American-Embedded/isolated_reindvstrialize_usb_hub/mfg/main/schematic.pdf

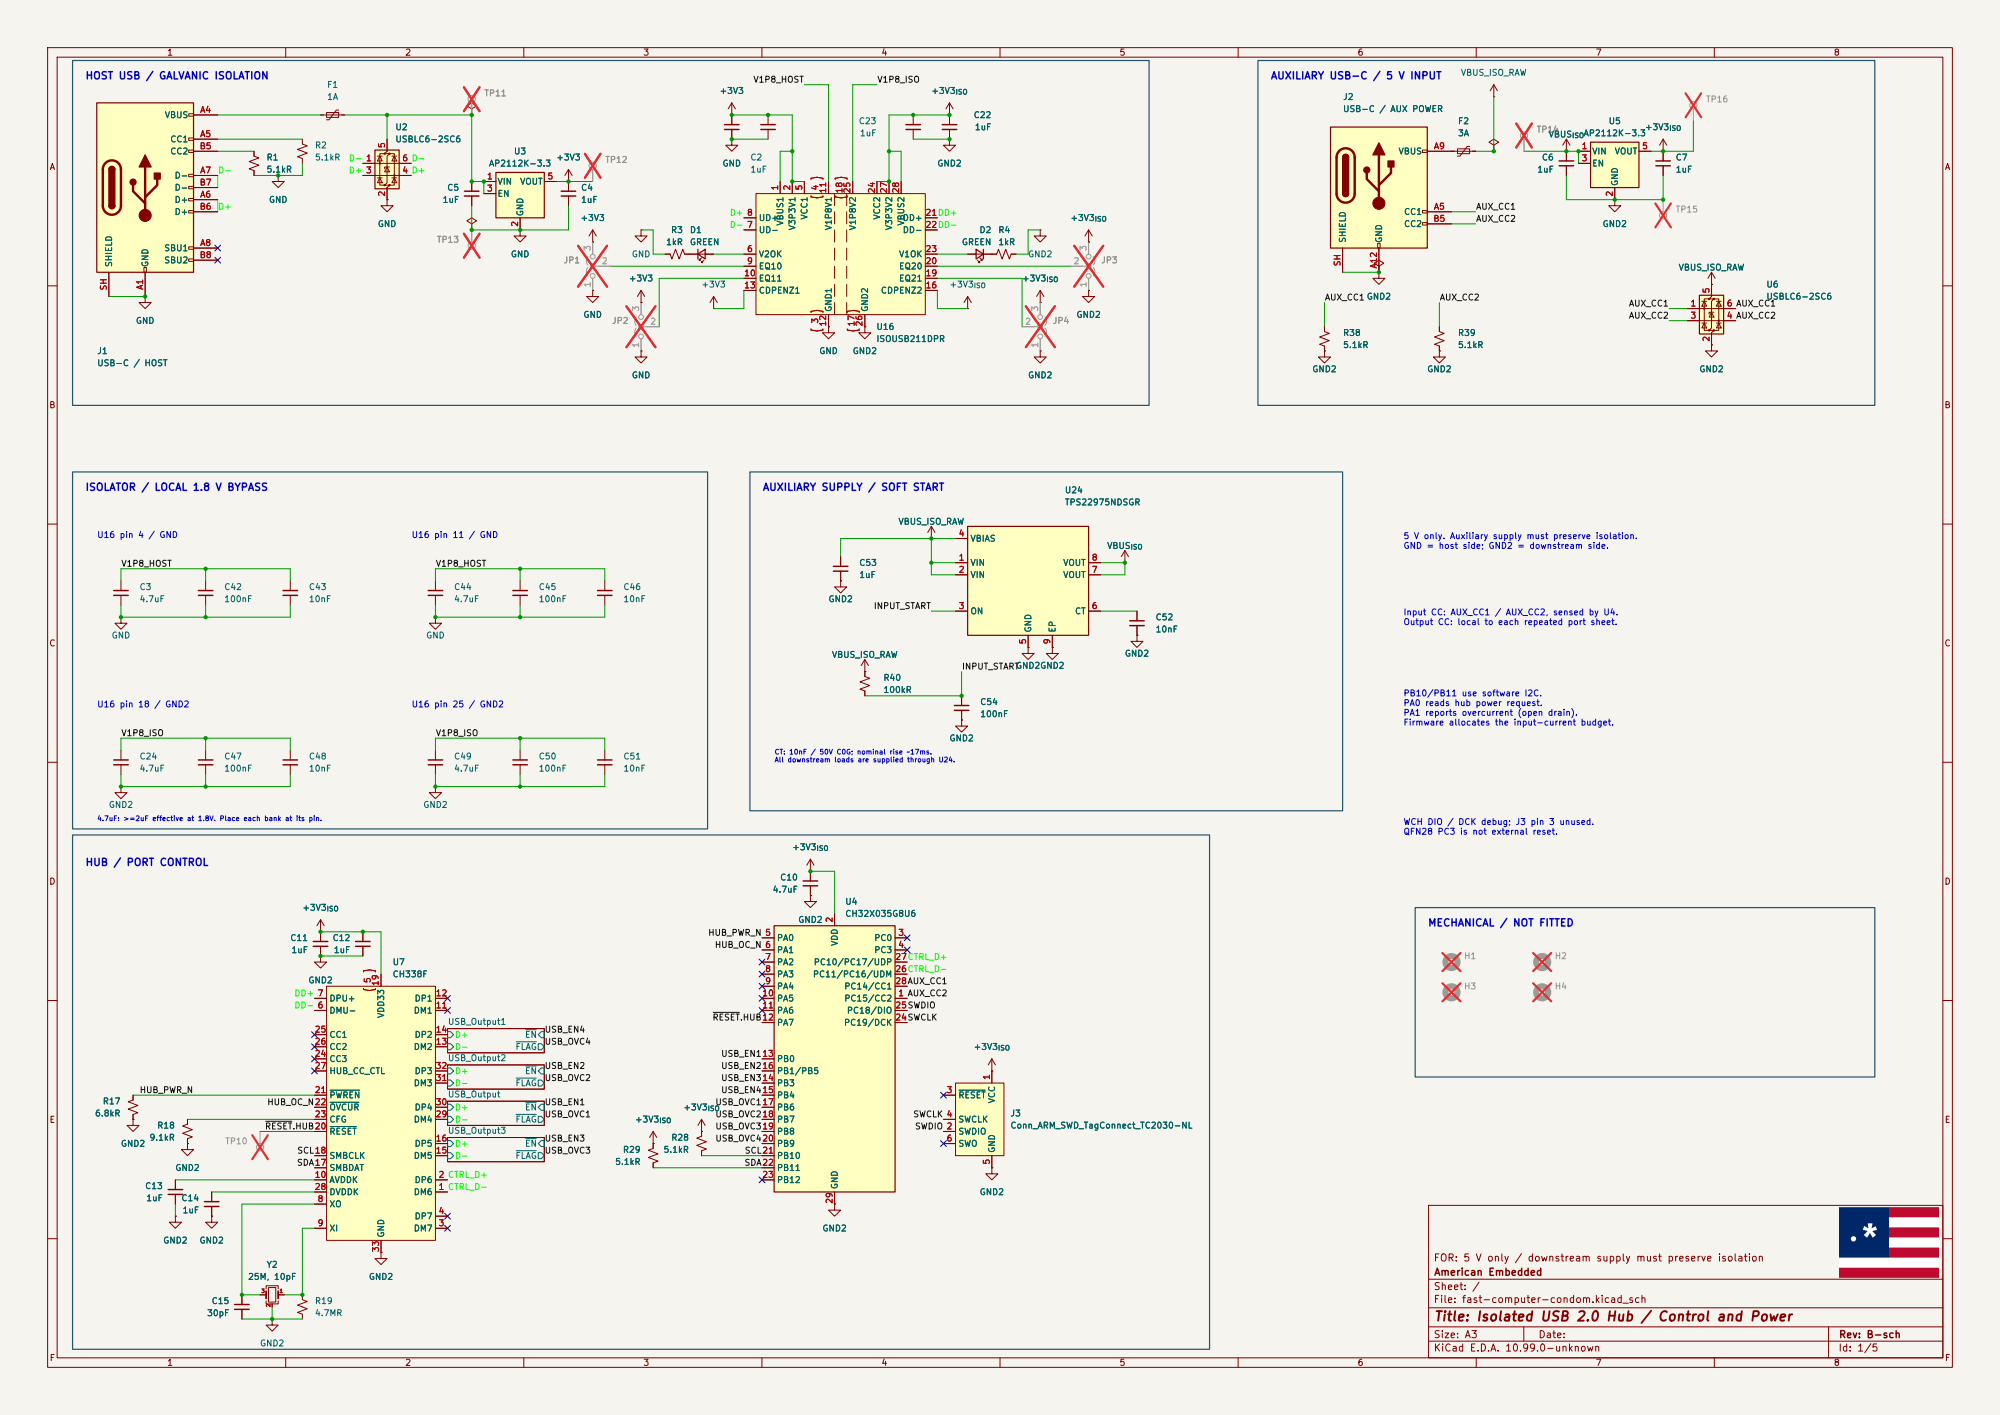
[picture p1: page 1]

HOST USB / GALVANIC ISOLATION

5 V only. Auxiliary supply must preserve isolation. GND = host side; GND2 = downstream side.

Input CC: AUX_CC1 / AUX_CC2, sensed by U4. Output CC: local to each repeated port sheet. PB10/PB11 use software I2C. PA0 reads hub power request. PA1 reports overcurrent (open drain). Firmware allocates the input-current budget.

2 PC0 3 PC3 4 PA0 5 PA1 6 PA2 7 PA3 8 PA4 9 PA5 10 PA6 11 PA7 12 PB0 13 PB3 14 PB4 15 PB6 17 PB7 18 PB8 19 PB9 20 PB10 21 PB11 22 PB12 23 PC19/DCK 24 PC18/DIO 25 PC11/PC16/UDM 26 PC10/PC17/UDP 27 PC14/CC1 28 GND 29

FOR: 5 V only / downstream supply must preserve isolation
American Embedded
Sheet: /
File: fast-computer-condom.kicad_sch
Title: Isolated USB 2.0 Hub / Control and Power

Size: A3 | Rev: B-sch | F Date:
KiCad E.D.A. 10.99.0-unknown | Id: 1/5

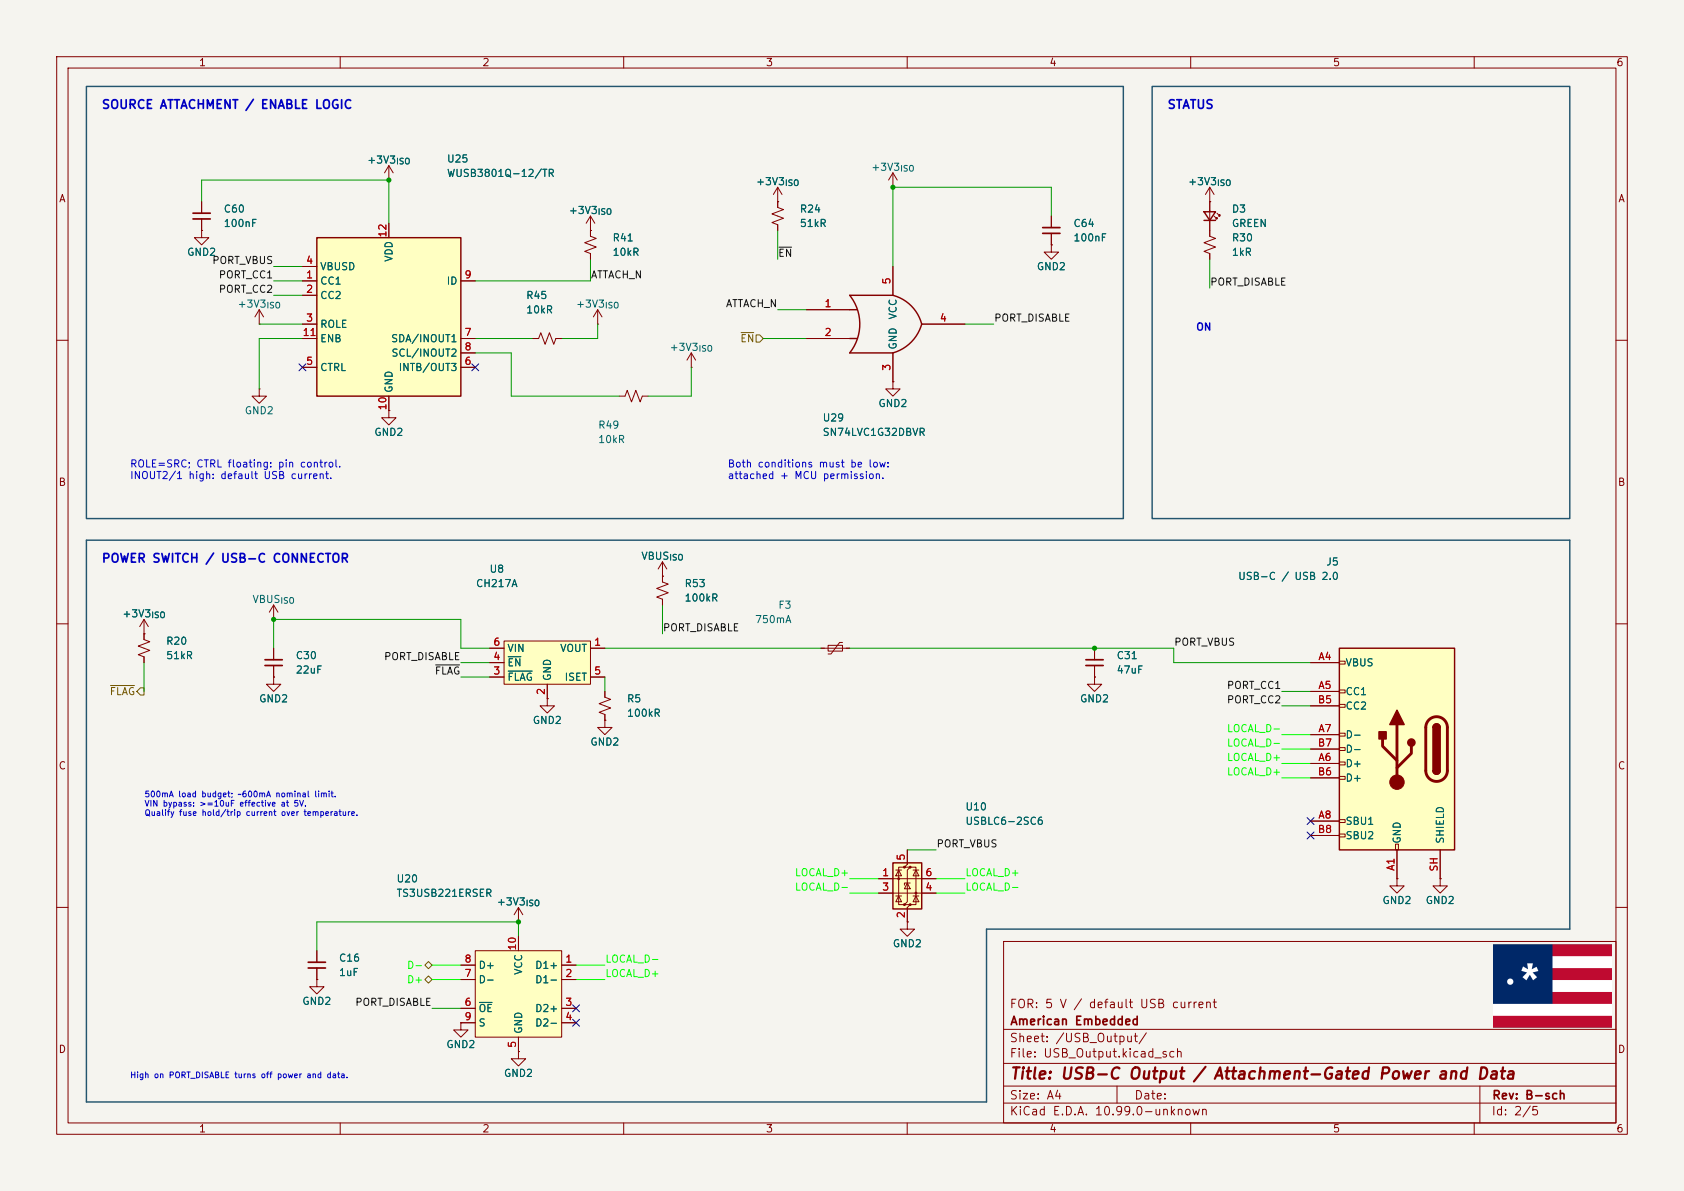
[picture p2: page 2]

SOURCE ATTACHMENT / ENABLE LOGIC

ROLE=SRC; CTRL floating: pin control.

500mA load budget; ~600mA nominal limit. VIN bypass: >=10uF effective at 5V. Qualify fuse hold/trip current over temperature. POWER SWITCH / USB-C CONNECTOR

FOR: 5 V / default USB current
American Embedded
Sheet: /USB_Output/
File: USB_Output.kicad_sch
Title: USB-C Output / Attachment-Gated Power and Data

High on PORT_DISABLE turns off power and data.

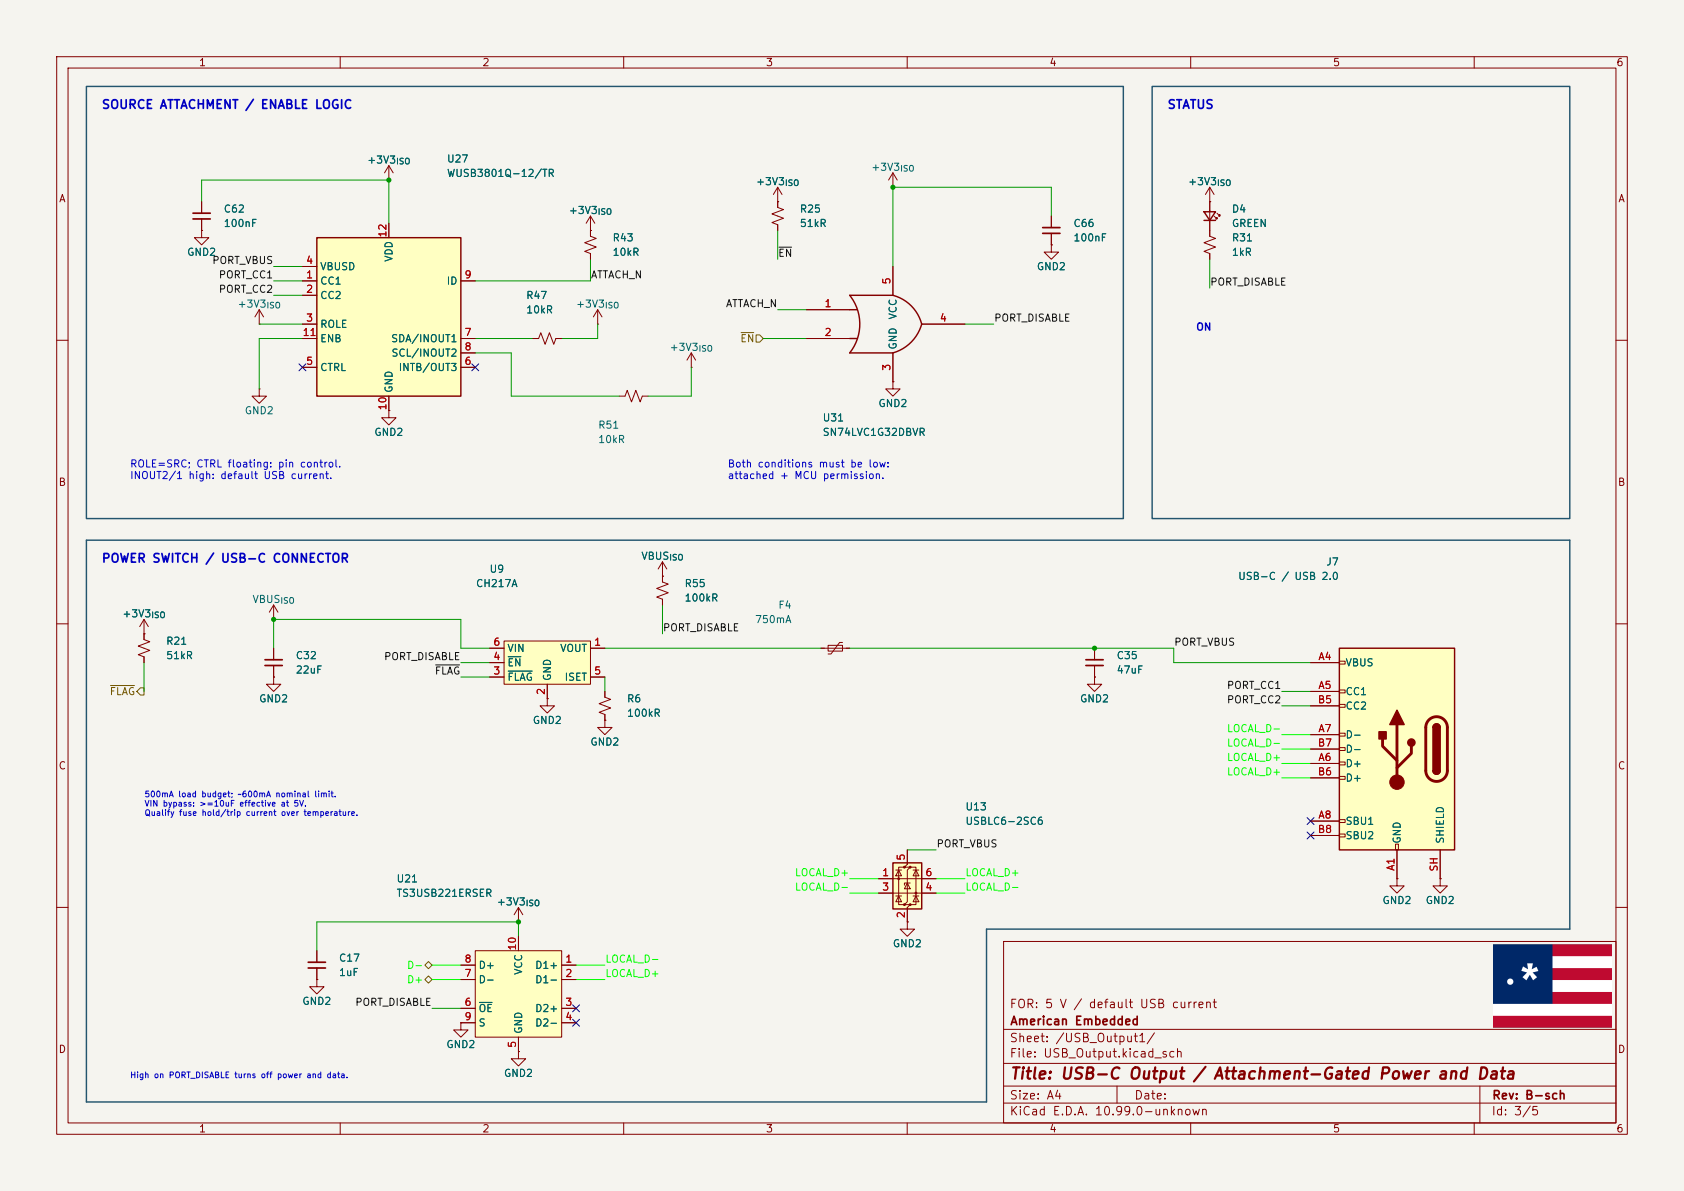
[picture p3: page 3]

SOURCE ATTACHMENT / ENABLE LOGIC
GND2 +3V3ISO GND2 C62

ROLE=SRC; CTRL floating: pin control.

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

FOR: 5 V / default USB current
American Embedded
Sheet: /USB_Output1/
File: USB_Output.kicad_sch
Title: USB-C Output / Attachment-Gated Power and Data

High on PORT_DISABLE turns off power and data.

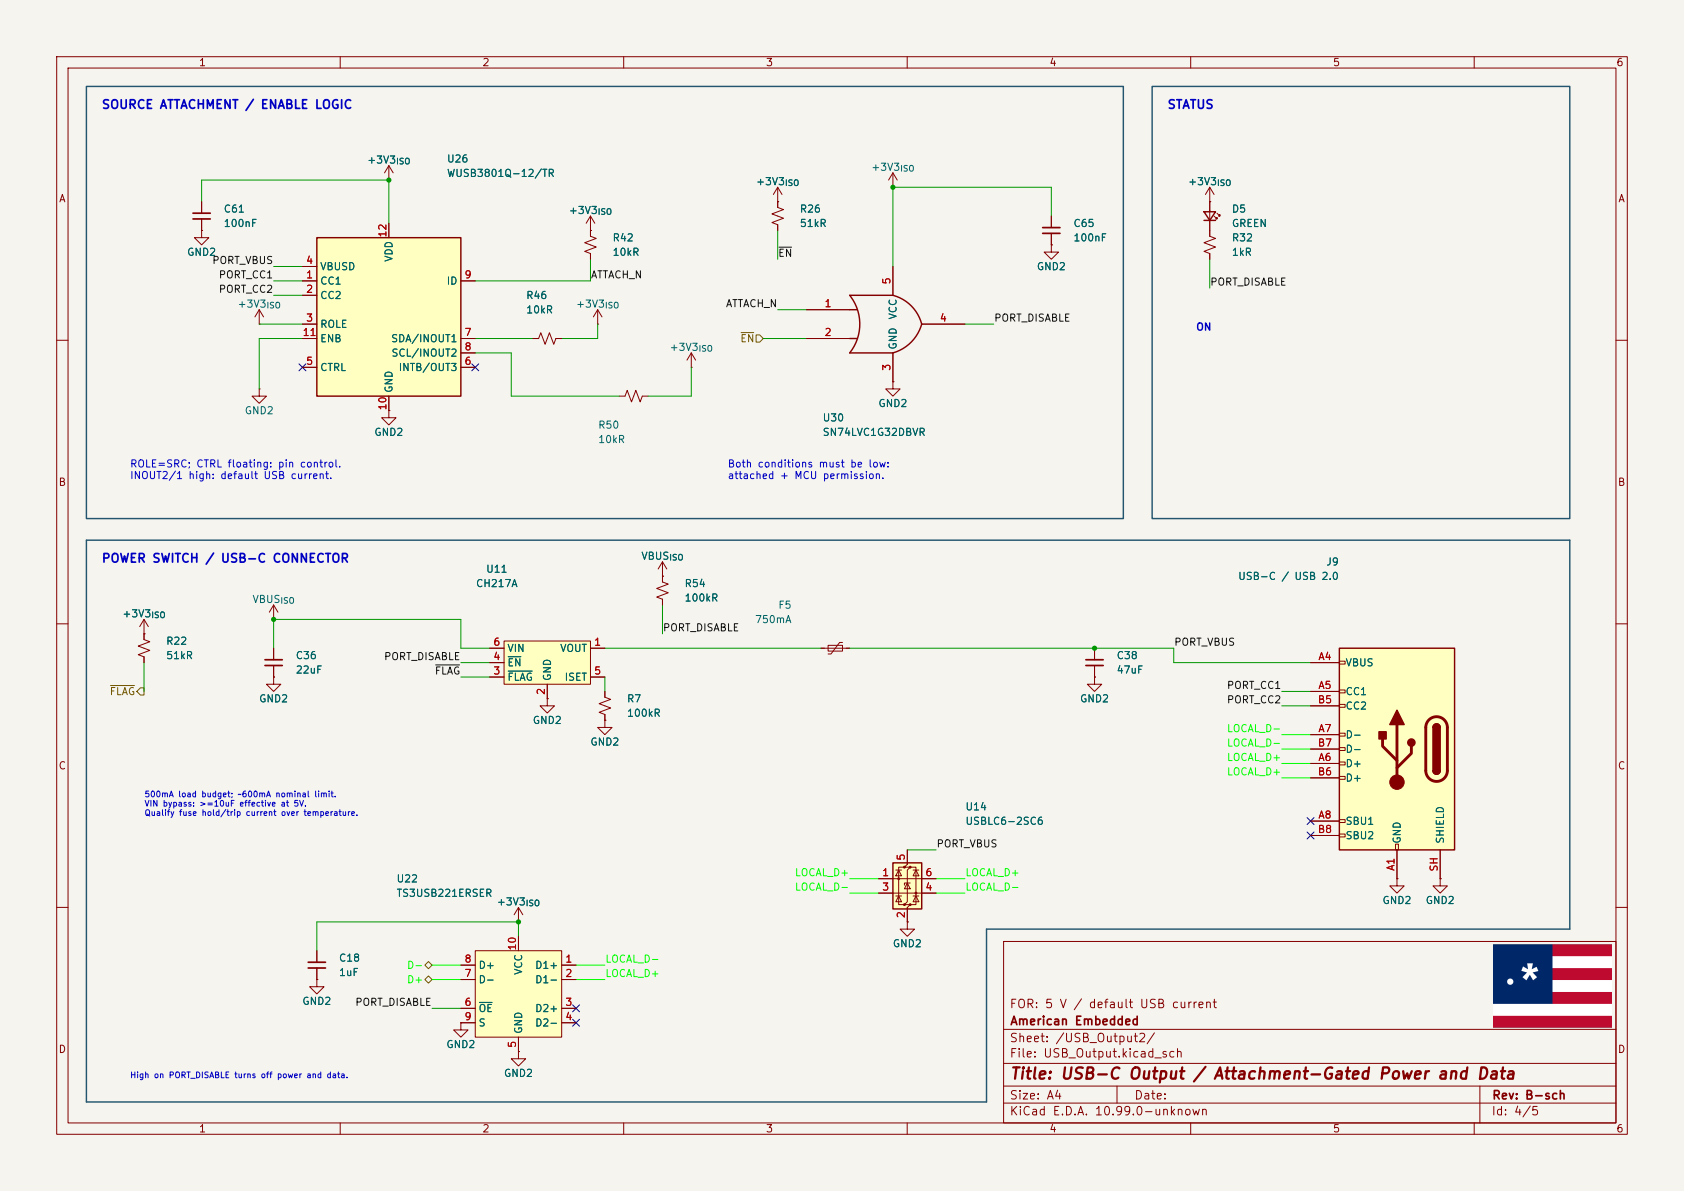
[picture p4: page 4]

ROLE=SRC; CTRL floating: pin control.

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

FOR: 5 V / default USB current
American Embedded
Sheet: /USB_Output2/
File: USB_Output.kicad_sch
Title: USB-C Output / Attachment-Gated Power and Data

High on PORT_DISABLE turns off power and data.

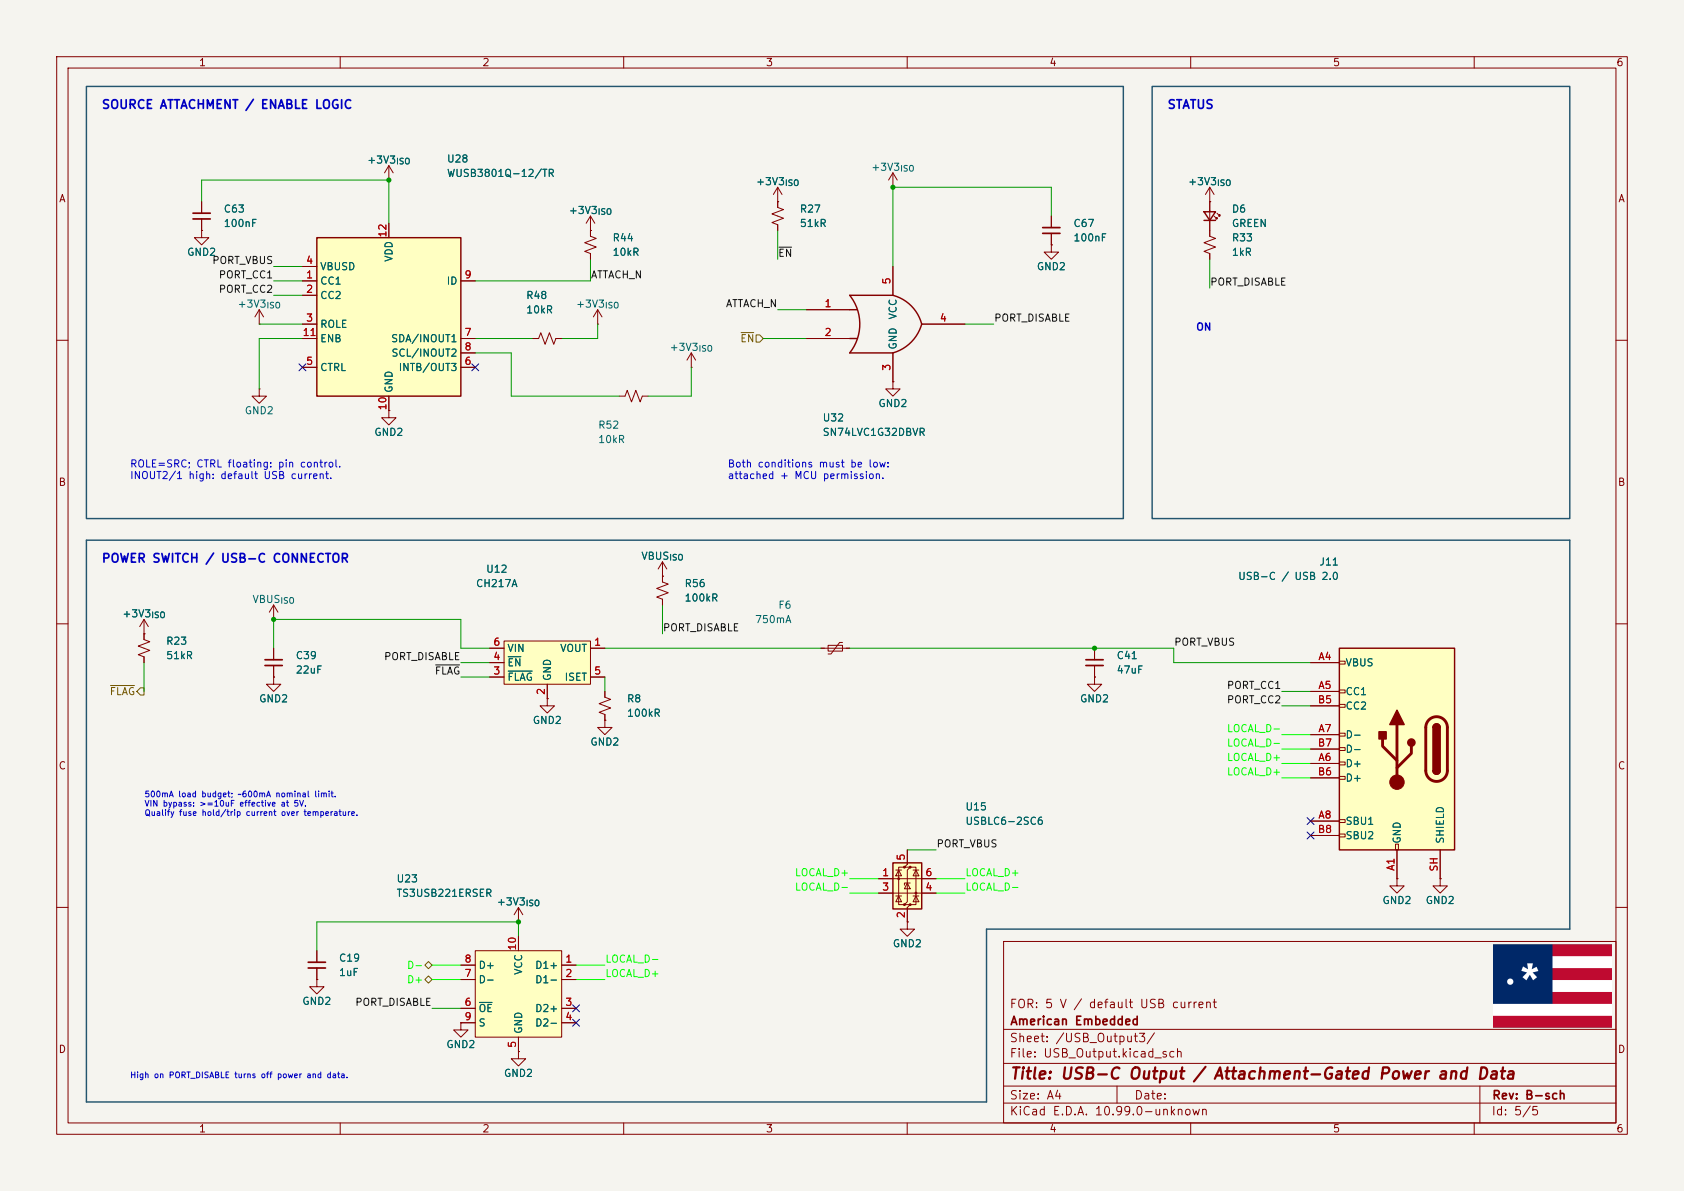
[picture p5: page 5]

SOURCE ATTACHMENT / ENABLE LOGIC

ROLE=SRC; CTRL floating: pin control.

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

FOR: 5 V / default USB current
American Embedded
Sheet: /USB_Output3/
File: USB_Output.kicad_sch
Title: USB-C Output / Attachment-Gated Power and Data

High on PORT_DISABLE turns off power and data.
