American-Embedded/isolated_reindvstrialize_usb_hub/fast-computer-condom.kicad_pcb

## KiCad design fast-computer-condom.kicad_pcb (2026-11-10)

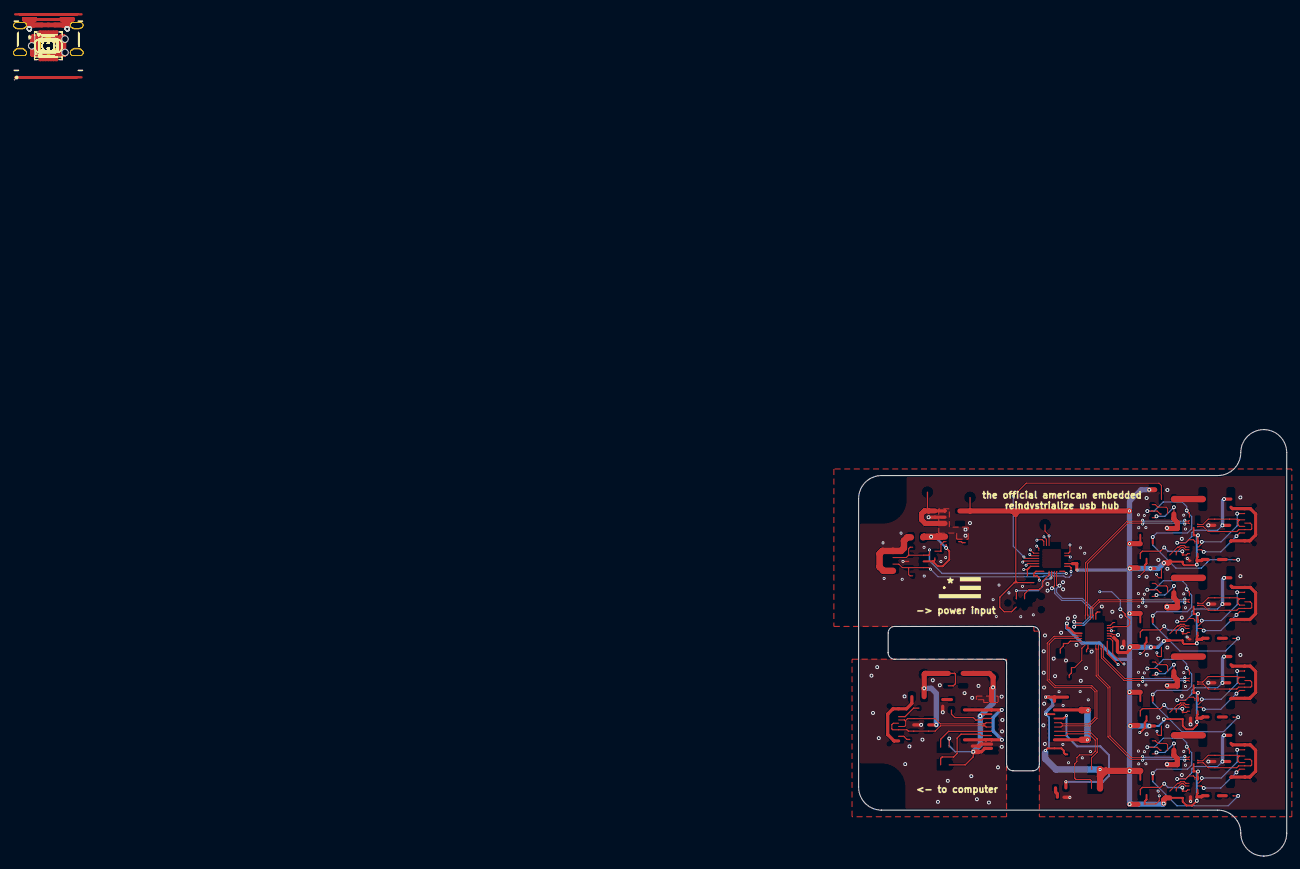
[picture p6: board fast-computer-condom.kicad_pcb from above]

Board: 6 copper layers, 65.2 x 65.0 mm, 156 parts (0 on the bottom side), 107 nets.

Parts:
C2, C4, C5, C6, C7, C11, C12, C13, C14, C16, C17, C18, C19, C20, C22, C23, C53: 1uF; C_0402_1005Metric
C3, C10, C24, C44, C49: 4.7uF; C_0603_1608Metric
C15: 30pF; C_0402_1005Metric
C30, C32, C36, C39: 22uF; C_1206_3216Metric
C31, C35, C38, C41: 47uF; C_1206_3216Metric
C42, C45, C47, C50, C54, C60, C61, C62, C63, C64, C65, C66, C67: 100nF; C_0402_1005Metric
C43, C46, C48, C51, C52: 10nF; C_0402_1005Metric
D1, D2, D3, D4, D5, D6: GREEN; LED_0603_1608Metric
F1: 1A; Fuse_0805_2012Metric
F2: 3A; Fuse_0805_2012Metric
F3, F4, F5, F6: 750mA; Fuse_1812_4532Metric
H1, H2, H3, H4: MountingHole; MountingHole_2.2mm_M2_DIN965_Pad_TopBottom
J1: USB-C / HOST; USB_C_Receptacle_HRO_TYPE-C-31-M-12-Edge_Silkscreen_Removed
J2: USB-C / AUX POWER; USB_C_Receptacle_HRO_TYPE-C-31-M-17-No-Silkscreen
J3: Conn_ARM_SWD_TagConnect_TC2030-NL; Tag-Connect_TC2030-IDC-NL_2x03_P1.27mm_Vertical
J5, J7, J9, J11: USB-C / USB 2.0; USB_C_Receptacle_HRO_TYPE-C-31-M-12-Edge_Silkscreen_Removed
JP1, JP2, JP3, JP4: Jumper_3_Open; SolderJumper-3_P1.3mm_Bridged12_RoundedPad1.0x1.5mm
R1, R2, R28, R29, R38, R39: 5.1kR; R_0402_1005Metric
R3, R4, R30, R31, R32, R33: 1kR; R_0402_1005Metric
R5, R6, R7, R8, R40, R53, R54, R55, R56: 100kR; R_0402_1005Metric
R17: 6.8kR; R_0402_1005Metric
R18: 9.1kR; R_0402_1005Metric
R19: 4.7MR; R_0402_1005Metric
R20, R21, R22, R23, R24, R25, R26, R27: 51kR; R_0402_1005Metric
R41, R42, R43, R44, R45, R46, R47, R48, R49, R50, R51, R52: 10kR; R_0402_1005Metric
TP10, TP11, TP12, TP13, TP14, TP15, TP16: TestPoint; TestPoint_Pad_D1.5mm
U2, U6, U10, U13, U14, U15: USBLC6-2SC6; SOT-23-6
U3, U5: AP2112K-3.3; SOT-23-5
U4: CH32X035G8U6; WQFN-28-1EP_4x4mm_P0.4mm_EP2.7x2.7mm_ThermalVias
U7: CH338F; QFN-32-1EP_4x4mm_P0.4mm_EP2.65x2.65mm_ThermalVias
U8, U9, U11, U12: CH217A; SOT-23-6
U16: ISOUSB211DPR; SSOP-28_L10.3-W7.5-P0.65-LS10.3-BL
U20, U21, U22, U23: TS3USB221ERSER; UQFN-10_L2.0-W1.5-P0.50-BL-EP
U24: TPS22975NDSGR; WSON-8_L2.0-W2.0-P0.50-TL-EP
U25, U26, U27, U28: WUSB3801Q-12/TR; X2QFN-12_L1.6-W1.6-P0.40-LS1.2
U29, U30, U31, U32: SN74LVC1G32DBVR; SOT-23-5
Y2: 25M, 10pF; Crystal_SMD_3225-4Pin_3.2x2.5mm

Connections:
+3V3: C2.1, C4.1, C20.1, JP1.3 (B), JP2.3 (B), TP12.1 (1_1), U3.5 (VOUT), U16.1 (VBUS1), U16.2 (V3P3V1), U16.5 (VCC1), U16.13 (CDPENZ1)
+3V3_{ISO}: C7.1, C10.1, C11.1, C12.1, C16.1, C17.1, C18.1, C19.1, C22.1, C23.1, C60.1, C61.1, C62.1, C63.1, C64.1, C65.1, C66.1, C67.1, D3.2 (A), D4.2 (A), D5.2 (A), D6.2 (A), J3.1 (VCC), JP3.3 (B), JP4.3 (B), R20.1, R21.1, R22.1, R23.1, R24.1, R25.1, R26.1, R27.1, R28.1, R29.1, R41.1, R42.1, R43.1, R44.1, R45.1, R46.1, R47.1, R48.1, R49.1, R50.1, R51.1, R52.1, TP16.1 (1_1), U4.2 (VDD), U5.5 (VOUT), U7.5 (VDD33), U7.19 (VDD33), U16.16 (CDPENZ2), U16.24 (VCC2), U16.27 (V3P3V2), U16.28 (VBUS2), U20.10 (VCC), U21.10 (VCC), U22.10 (VCC), U23.10 (VCC), U25.3 (ROLE), U25.12 (VDD), U26.3 (ROLE), U26.12 (VDD), U27.3 (ROLE), U27.12 (VDD), U28.3 (ROLE), U28.12 (VDD), U29.5 (VCC), U30.5 (VCC), U31.5 (VCC), U32.5 (VCC)
/AUX_CC1: J2.A5 (CC1), R38.1, U4.28 (PC14/CC1), U6.1 (I/O1), U6.6 (I/O1)
/AUX_CC2: J2.B5 (CC2), R39.1, U4.1 (PC15/CC2), U6.3 (I/O2), U6.4 (I/O2)
/CTRL_D+: U4.27 (PC10/PC17/UDP), U7.2 (DP6)
/CTRL_D-: U4.26 (PC11/PC16/UDM), U7.1 (DM6)
/D+: J1.A6 (D+), J1.B6 (D+), U2.3 (I/O2), U2.4 (I/O2), U16.8 (UD+)
/D-: J1.A7 (D-), J1.B7 (D-), U2.1 (I/O1), U2.6 (I/O1), U16.7 (UD-)
/DD+: U7.7 (DPU+), U16.21 (DD+)
/DD-: U7.6 (DMU-), U16.22 (DD-)
/HUB_OC_N: U4.6 (PA1), U7.22 (~OVCUR)
/HUB_PWR_N: R17.1, U4.5 (PA0), U7.21 (~PWREN)
/INPUT_START: C54.1, R40.2, U24.3 (ON)
/SCL: R28.2, U4.21 (PB10), U7.18 (SMBCLK)
/SDA: R29.2, U4.22 (PB11), U7.17 (SMBDAT)
/SWCLK: J3.4 (SWCLK), U4.24 (PC19/DCK)
/SWDIO: J3.2 (SWDIO), U4.25 (PC18/DIO)
/USB_EN1: R24.2, U4.13 (PB0), U29.2
/USB_EN2: R26.2, U4.16 (PB1/PB5), U30.2
/USB_EN3: R27.2, U4.14 (PB3), U32.2
/USB_EN4: R25.2, U4.15 (PB4), U31.2
/USB_OVC1: R20.2, U4.17 (PB6), U8.3 (~FLAG)
/USB_OVC2: R22.2, U4.18 (PB7), U11.3 (~FLAG)
/USB_OVC3: R23.2, U4.19 (PB8), U12.3 (~FLAG)
/USB_OVC4: R21.2, U4.20 (PB9), U9.3 (~FLAG)
/USB_Output1/ATTACH_N: R43.2, U27.9 (ID), U31.1
/USB_Output1/D+: U7.14 (DP2), U21.7 (D-)
/USB_Output1/D-: U7.13 (DM2), U21.8 (D+)
/USB_Output1/LOCAL_D+: J7.A6 (D+), J7.B6 (D+), U13.1 (I/O1), U13.6 (I/O1), U21.2 (D1-)
/USB_Output1/LOCAL_D-: J7.A7 (D-), J7.B7 (D-), U13.3 (I/O2), U13.4 (I/O2), U21.1 (D1+)
/USB_Output1/PORT_CC1: J7.A5 (CC1), U27.1 (CC1)
/USB_Output1/PORT_CC2: J7.B5 (CC2), U27.2 (CC2)
/USB_Output1/PORT_DISABLE: R31.2, R55.2, U9.4 (~EN), U21.6 (~OE), U31.4
/USB_Output1/PORT_VBUS: C35.1, F4.2, J7.A4 (VBUS), J7.A9 (VBUS), J7.B4 (VBUS), J7.B9 (VBUS), U13.5 (VBUS), U27.4 (VBUSD)
/USB_Output2/ATTACH_N: R42.2, U26.9 (ID), U30.1
/USB_Output2/D+: U7.32 (DP3), U22.7 (D-)
/USB_Output2/D-: U7.31 (DM3), U22.8 (D+)
/USB_Output2/LOCAL_D+: J9.A6 (D+), J9.B6 (D+), U14.1 (I/O1), U14.6 (I/O1), U22.2 (D1-)
/USB_Output2/LOCAL_D-: J9.A7 (D-), J9.B7 (D-), U14.3 (I/O2), U14.4 (I/O2), U22.1 (D1+)
/USB_Output2/PORT_CC1: J9.A5 (CC1), U26.1 (CC1)
/USB_Output2/PORT_CC2: J9.B5 (CC2), U26.2 (CC2)
/USB_Output2/PORT_DISABLE: R32.2, R54.2, U11.4 (~EN), U22.6 (~OE), U30.4
/USB_Output2/PORT_VBUS: C38.1, F5.2, J9.A4 (VBUS), J9.A9 (VBUS), J9.B4 (VBUS), J9.B9 (VBUS), U14.5 (VBUS), U26.4 (VBUSD)
/USB_Output3/ATTACH_N: R44.2, U28.9 (ID), U32.1
/USB_Output3/D+: U7.16 (DP5), U23.7 (D-)
/USB_Output3/D-: U7.15 (DM5), U23.8 (D+)
/USB_Output3/LOCAL_D+: J11.A6 (D+), J11.B6 (D+), U15.1 (I/O1), U15.6 (I/O1), U23.2 (D1-)
/USB_Output3/LOCAL_D-: J11.A7 (D-), J11.B7 (D-), U15.3 (I/O2), U15.4 (I/O2), U23.1 (D1+)
/USB_Output3/PORT_CC1: J11.A5 (CC1), U28.1 (CC1)
/USB_Output3/PORT_CC2: J11.B5 (CC2), U28.2 (CC2)
/USB_Output3/PORT_DISABLE: R33.2, R56.2, U12.4 (~EN), U23.6 (~OE), U32.4
/USB_Output3/PORT_VBUS: C41.1, F6.2, J11.A4 (VBUS), J11.A9 (VBUS), J11.B4 (VBUS), J11.B9 (VBUS), U15.5 (VBUS), U28.4 (VBUSD)
/USB_Output/ATTACH_N: R41.2, U25.9 (ID), U29.1
/USB_Output/D+: U7.30 (DP4), U20.7 (D-)
/USB_Output/D-: U7.29 (DM4), U20.8 (D+)
/USB_Output/LOCAL_D+: J5.A6 (D+), J5.B6 (D+), U10.1 (I/O1), U10.6 (I/O1), U20.2 (D1-)
/USB_Output/LOCAL_D-: J5.A7 (D-), J5.B7 (D-), U10.3 (I/O2), U10.4 (I/O2), U20.1 (D1+)
/USB_Output/PORT_CC1: J5.A5 (CC1), U25.1 (CC1)
/USB_Output/PORT_CC2: J5.B5 (CC2), U25.2 (CC2)
/USB_Output/PORT_DISABLE: R30.2, R53.2, U8.4 (~EN), U20.6 (~OE), U29.4
/USB_Output/PORT_VBUS: C31.1, F3.2, J5.A4 (VBUS), J5.A9 (VBUS), J5.B4 (VBUS), J5.B9 (VBUS), U10.5 (VBUS), U25.4 (VBUSD)
/V1P8_HOST: C3.1, C42.1, C43.1, C44.1, C45.1, C46.1, U16.4 (V1P8V1), U16.11 (V1P8V1)
/V1P8_ISO: C24.1, C47.1, C48.1, C49.1, C50.1, C51.1, U16.18 (V1P8V2), U16.25 (V1P8V2)
/~RESET.HUB: TP10.1 (1_1), U4.12 (PA7), U7.20 (~RESET)
GND: C2.2, C3.2, C4.2, C5.2, C20.2, C42.2, C43.2, C44.2, C45.2, C46.2, J1.A1 (GND), J1.A12 (GND), J1.B1 (GND), J1.B12 (GND), J1.SH (SHIELD), JP1.1 (A), JP2.1 (A), R1.2, R2.2, R3.2, TP13.1 (1_1), U2.2 (GND), U3.2 (GND), U16.3 (GND1), U16.12 (GND1)
GND2: C6.2, C7.2, C10.2, C11.2, C12.2, C13.2, C14.2, C15.2, C16.2, C17.2, C18.2, C19.2, C22.2, C23.2, C24.2, C30.2, C31.2, C32.2, C35.2, C36.2, C38.2, C39.2, C41.2, C47.2, C48.2, C49.2, C50.2, C51.2, C52.2, C53.2, C54.2, C60.2, C61.2, C62.2, C63.2, C64.2, C65.2, C66.2, C67.2, J2.A12 (GND), J2.B12 (GND), J2.SH (SHIELD), J3.5 (GND), J5.A1 (GND), J5.A12 (GND), J5.B1 (GND), J5.B12 (GND), J5.SH (SHIELD), J7.A1 (GND), J7.A12 (GND), J7.B1 (GND), J7.B12 (GND), J7.SH (SHIELD), J9.A1 (GND), J9.A12 (GND), J9.B1 (GND), J9.B12 (GND), J9.SH (SHIELD), J11.A1 (GND), J11.A12 (GND), J11.B1 (GND), J11.B12 (GND), J11.SH (SHIELD), JP3.1 (A), JP4.1 (A), R4.2, R5.2, R6.2, R7.2, R8.2, R17.2, R18.2, R19.2, R38.2, R39.2, TP15.1 (1_1), U4.29 (GND), U5.2 (GND), U6.2 (GND), U7.33 (GND), U8.2 (GND), U9.2 (GND), U10.2 (GND), U11.2 (GND), U12.2 (GND), U13.2 (GND), U14.2 (GND), U15.2 (GND), U16.17 (GND2), U16.26 (GND2), U20.5 (GND), U20.9 (S), U21.5 (GND), U21.9 (S), U22.5 (GND), U22.9 (S), U23.5 (GND), U23.9 (S), U24.5 (GND), U24.9 (EP), U25.10 (GND), U25.11 (ENB), U26.10 (GND), U26.11 (ENB), U27.10 (GND), U27.11 (ENB), U28.10 (GND), U28.11 (ENB), U29.3 (GND), U30.3 (GND), U31.3 (GND), U32.3 (GND), Y2.2 (G), Y2.4 (G)
unnamed: D1.2 (A), U16.6 (V2OK)
unnamed: D1.1 (K), R3.1
unnamed: D2.2 (A), U16.23 (V1OK)
unnamed: D2.1 (K), R4.1
unnamed: D3.1 (K), R30.1
unnamed: D4.1 (K), R31.1
unnamed: D5.1 (K), R32.1
unnamed: D6.1 (K), R33.1
unnamed: F1.1, J1.A4 (VBUS), J1.A9 (VBUS), J1.B4 (VBUS), J1.B9 (VBUS)
unnamed: F2.1, J2.A9 (VBUS), J2.B9 (VBUS)
unnamed: J1.A5 (CC1), R2.1
unnamed: J1.B5 (CC2), R1.1
unnamed: JP1.2 (C), U16.9 (EQ10)
unnamed: JP2.2 (C), U16.10 (EQ11)
unnamed: JP3.2 (C), U16.20 (EQ20)
unnamed: JP4.2 (C), U16.19 (EQ21)
unnamed: C5.1, F1.2, TP11.1 (1_1), U2.5 (VBUS), U3.1 (VIN), U3.3 (EN)
unnamed: C13.1, U7.10 (AVDDK)
unnamed: R18.1, U7.23 (CFG)
unnamed: C14.1, U7.28 (DVDDK)
unnamed: R19.1, U7.9 (XI), Y2.1
unnamed: C15.1, U7.8 (XO), Y2.3
unnamed: R5.1, U8.5 (ISET)
unnamed: F3.1, U8.1 (VOUT)
unnamed: R6.1, U9.5 (ISET)
unnamed: F4.1, U9.1 (VOUT)
unnamed: R7.1, U11.5 (ISET)
unnamed: F5.1, U11.1 (VOUT)
unnamed: R8.1, U12.5 (ISET)
unnamed: F6.1, U12.1 (VOUT)
unnamed: C52.1, U24.6 (CT)
unnamed: R49.2, U25.8 (SCL/INOUT2)
unnamed: R45.2, U25.7 (SDA/INOUT1)
unnamed: R50.2, U26.8 (SCL/INOUT2)
unnamed: R46.2, U26.7 (SDA/INOUT1)
unnamed: R51.2, U27.8 (SCL/INOUT2)
unnamed: R47.2, U27.7 (SDA/INOUT1)
unnamed: R52.2, U28.8 (SCL/INOUT2)
unnamed: R48.2, U28.7 (SDA/INOUT1)
VBUS_ISO_RAW: C53.1, F2.2, R40.1, U6.5 (VBUS), U24.1 (VIN), U24.2 (VIN), U24.4 (VBIAS)
VBUS_{ISO}: C6.1, C30.1, C32.1, C36.1, C39.1, R53.1, R54.1, R55.1, R56.1, TP14.1 (1_1), U5.1 (VIN), U5.3 (EN), U8.6 (VIN), U9.6 (VIN), U11.6 (VIN), U12.6 (VIN), U24.7 (VOUT), U24.8 (VOUT)
